SaktanuthPeak/durian-bot/docs/doc.pdf

โครงร่าร่ | งรายงาน Durian Bot (Mini Project 240-319)
ไฟล์นี้เป็น โครงร่าร่ | ง + เนื้อหาคร่าร่ | วๆ สำ หรับรั | นำ ไปเรียรี | บเรียรี | งลงรายงาน Word อิงโครงสร้าร้ | งจากตัวอย่าย่ | ง Report_SmartHome-
1.pdf และ MiniProject-SmartCargo-2.pdf
ข้อข้ | ความใน [วงเล็บเหลี่ยม] = ต้องเติมเอง (ชื่อชื่ | , รูปถ่าย, ผลทดลอง, ราคา)
แผนภาพเขียขี | นด้วย Mermaid — เปิดใน VS Code/GitHub เพื่อพื่ | ดู หรือรื | วางที่ https://mermaid.live แล้ว export เป็น PNG

## ไปแปะใน Word

Code ที่แปะเป็น ส่วส่ | นสำ คัญที่ตัดมา พร้อร้ | มชื่อชื่ | ไฟล์และบรรทัดอ้างอิง ไม่ใม่ | ช่ทั้ช่ | ทั้งทั้ | ไฟล์
ภาคผนวก Z ท้ายไฟล์เป็นบันบั | ทึกสำ หรับรั | ทีม (สิ่งสิ่ | ที่ยังยั | ขาดตามเนื้อหาวิชวิ | า + จุดที่ควรแก้) — ลบออกก่อนส่งส่
หน้าน้ | ปก

### รายงาน

Mini project วิชวิ | า 240-319 Embedded System Developer Module
หุ่นหุ่ | ยนต์ฉีดพ่นพ่ | ยาในสวนทุเทุ | รียรี | น (Durian Bot)
จัดจั | ทำ โดย
[ชื่อชื่ | -สกุลกุ | ] รหัสหั | นักนั | ศึกษา [xxxxxxxxxx] Section [xx]
[ชื่อชื่ | -สกุลกุ | ] รหัสหั | นักนั | ศึกษา [xxxxxxxxxx] Section [xx]
[ชื่อชื่ | -สกุลกุ | ] รหัสหั | นักนั | ศึกษา [xxxxxxxxxx] Section [xx]

### เสนอ รศ.ดร. ปัญญยศ ไชยกาฬ

ผศ.ดร. วชรินริ | ทร์ แก้วอภิชัยชั
รศ.ดร. ทวีศัวี | ศักดิ์ เรือรื | งพีรพี | ะกุลกุ
รายงานฉบับบั | นี้เนี้ป็นป็ | ส่วส่ | นหนึ่งนึ่ | ของรายวิชวิ | า 240-319 ชุดวิชวิ | านักพัฒพั | นาระบบฝังตัว
(Embedded System Developer Module)
คณะวิศวิ | วกรรมศาสตร์ สาขาวิศวิ | วกรรมคอมพิวพิ | เตอร์
มหาวิทวิ | ยาลัยสงขลานครินริ | ทร์ วิทวิ | ยาเขตหาดใหญ่
ภาคเรียรี | นที่ | [x] ปีกปี | ารศึกษา [25xx]

คำ นำ

รายงานฉบับบั | นี้เป็นส่วส่ | นหนึ่งของรายวิชวิ | า 240-319 ชุดวิชวิ | านักพัฒพั | นาระบบฝังตัว (Embedded System Developer Module) จัดจั | ทำ ขึ้นขึ้ | เพื่อพื่
ศึกษา ออกแบบ และพัฒพั | นาหุ่นหุ่ | ยนต์ต้นแบบ "Durian Bot" สำ หรับรั | ช่วช่ | ยฉีดพ่นพ่ | สารในสวนทุเทุ | รียรี | น โดยประยุกต์ใช้คช้ | วามรู้ใรู้ | นรายวิชา วิ | ได้แก่
GPIO, PWM, ADC, Interrupt, Watchdog Timer, Sleep Mode, UART/USART, SPI, I2C, CAN Bus, RTOS, EEPROM และการ
ประมวลผลภาพด้วย OpenCV ร่วร่ | มกับ Raspberry Pi และเว็บว็ | แอปพลิเคชันชั | เพื่อพื่ | ให้ผู้ห้ | คผู้ วบคุมคุ | สั่งสั่ | งานและติดตามสถานะหุ่นหุ่ | ยนต์ได้จากระยะ

## ไกล

คณะผู้จัผู้ ดจั | ทำ หวังวั | ว่าว่ | รายงานฉบับบั | นี้จะเป็นประโยชน์แก่ผู้อ่ผู้ อ่าน หากมีข้มี | อข้ | ผิดผิ | พลาดประการใด คณะผู้จัผู้ ดจั | ทำ ขออภัยมา ณ ที่นี้
คณะผู้จัผู้ ดจั | ทำ | [วันวั | ที่]

สารบัญบั | / สารบัญบั | ภาพ / สารบัญบั | ตาราง
สร้าร้ | งอัตโนมัติมั ติใน Word (References → Table of Contents / Insert Table of Figures) หลังจัดจั | หัวหั | ข้อข้ | ด้วย Heading Style

บทที่ 1 บทนำ

# 1.1 ที่มาและความสำ คัญ

ทุเทุ | รียรี | นเป็นพืชพื | เศรษฐกิจสำ คัญของภาคใต้ การดูแดู | ลสวนต้องฉีดพ่นพ่ | สารป้อป้ | งกันโรคและแมลง (เช่นช่ | โรครากเน่าโคนเน่า, หนอนเจาะผล) อย่าย่ | ง
สม่ำ เสมอ ในทางปฏิบัติบั ติเกษตรกรต้องแบกถังหรือรื | ลากสายพ่นพ่ | เดินไปตามแถวต้นเอง ซึ่งซึ่
เสี่ยสี่ | งสัมสั | ผัสผั | สารเคมีโมี | ดยตรงทั้งทั้ | ทางผิวผิ | หนังและการหายใจ
ใช้แช้ | รงงานและเวลามาก โดยเฉพาะสวนขนาดใหญ่ที่แรงงานขาดแคลน
ปริมริ | าณการพ่นพ่ | ไม่สม่ | ม่ำ เสมอขึ้นขึ้ | กับผู้พ่ผู้ นพ่ | แต่ละคน
คณะผู้จัผู้ ดจั | ทำ จึงจึ | พัฒพั | นา Durian Bot หุ่นหุ่ | ยนต์ขับขั | เคลื่อน 4 ล้อที่ติดตั้งตั้ | ปั๊มและหัวหั | ฉีดปรับรั | มุมได้ ผู้คผู้ วบคุมคุ | บังบั | คับจาก ระยะไกลได้ 2 ช่อช่ | งทาง คือ
จอย PS2 ผ่าผ่ | น CAN Bus และหน้าเว็บว็ | ผ่าผ่ | น Wi-Fi ของ Raspberry Pi บนตัวหุ่นหุ่ | พร้อร้ | ม ภาพจากกล้องและสถานะของหุ่นหุ่ | แบบเวลาจริงริ | ช่วช่ | ย
ให้ผู้ห้ | คผู้ วบคุมคุ | อยู่ห่ยู่ | าห่ | งจากละอองสารเคมี
1.2 วัตวั | ถุปถุ | ระสงค์
1. เพื่อพื่ | ออกแบบและพัฒพั | นาหุ่นหุ่ | ยนต์ต้นแบบสำ หรับรั | ฉีดพ่นพ่ | สารในสวนทุเทุ | รียรี | นที่ควบคุมคุ | จากระยะไกลได้
2. เพื่อพื่ | ประยุกต์ใช้กช้ | ารสื่อสื่ | สารระหว่าว่ | งไมโครคอนโทรลเลอร์หร์ | ลายบอร์ดร์ | ผ่าผ่ | น CAN Bus, SPI, I2C และ UART
3. เพื่อพื่ | ออกแบบระบบความปลอดภัย (fail-safe) เช่นช่ | Watchdog Timer และการหยุดอัตโนมัติมั ติเมื่อมื่ | สัญสั | ญาณขาด
4. เพื่อพื่ | พัฒพั | นาเว็บว็ | แดชบอร์ดร์ | บน Raspberry Pi สำ หรับรั | สั่งสั่ | งาน แสดงภาพจากกล้อง (OpenCV) และสถานะหุ่นหุ่ | ยนต์

# 1.3 ขอบเขตของโครงงาน

เป็นการจำ ลองตัวต้นแบบขนาดเล็ก โดยใช้คช้ | วามรู้ใรู้ | นรายวิชวิ | า Embedded System Developer Module
ใช้น้ำช้ | น้ำ | แทนสารเคมีจมี | ริงริ | ในการทดสอบ
ควบคุมคุ | แบบ manual (ผู้คผู้ วบคุมคุ | บังบั | คับ) ยังยั | ไม่มีม่ | กมี | ารนำ ทางอัตโนมัติมั ติ
ระยะการควบคุมคุ | ผ่าผ่ | นเว็บว็ | จำ กัดตามระยะ Wi-Fi Access Point ของ Raspberry Pi

บทที่ 2 เอกสารและทฤษฎีที่เกี่ยวข้อข้ | ง
แนวเดียวกับตัวอย่าย่ | ง SmartHome บทที่ 2: อธิบธิ | ายอุปกรณ์แต่ละตัว + รูปประกอบ (ภาพ pinout) แล้วเพิ่มพิ่ | ส่วส่ | น 2.2 ทฤษฎีตาม
เนื้อหาวิชวิ | า ที่ผูกผู | กับโค้ดจริงริ | ในโปรเจกต์ (อาจารย์น่ย์ | น่าจะดูส่ดู | วส่ | นนี้เป็นหลัก)
ที่ | กี่

เกี่ยวข้อข้ | ง
หัวข้อข้ ย่อย่ ย | เนื้อนื้ หาคร่าร่ วๆ | ใช้ใช้ นโปรเจกต์

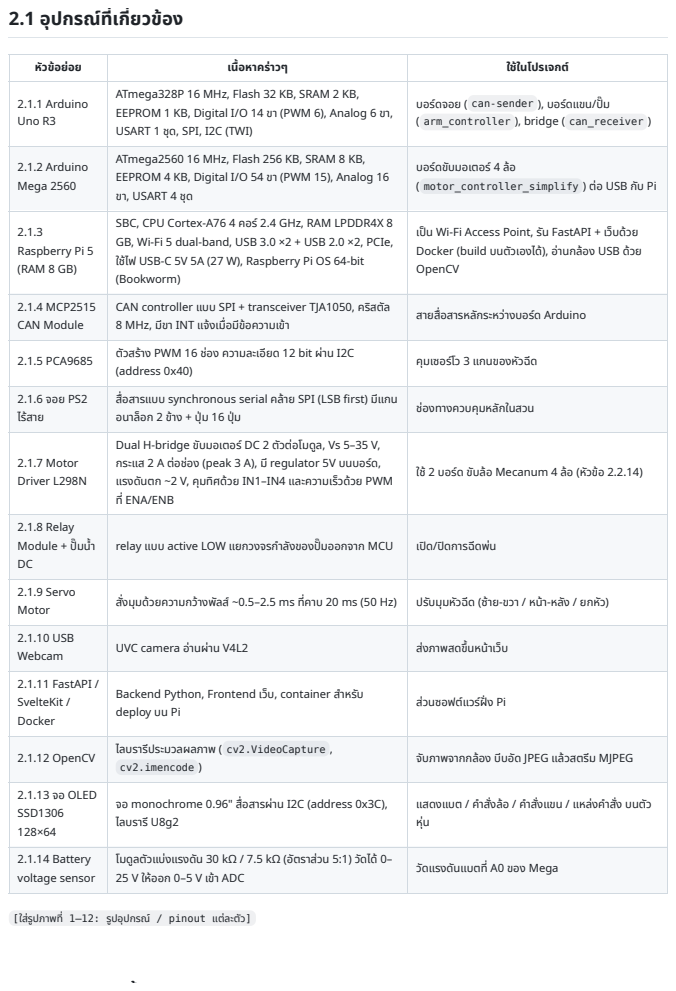
[picture p8: page 5]
2.1 อุปกรณ์ที่ณ์ ที่; ภาพที่; อุปกรณ์ / pinout ณ์; แต่ละตัว]

2.1.1 Arduino Uno R3 | ATmega328P 16 MHz, Flash 32 KB, SRAM 2 KB, EEPROM 1 KB, Digital I/O 14 ขา (PWM 6), Analog 6 ขา, USART 1 ชุด, SPI, I2C (TWI) | บอร์ดร์ จอย ( can-sender ), บอร์ดร์ แขน/ปั๊ม ( arm_controller ), bridge ( can_receiver )

2.1.2 Arduino Mega 2560 | ATmega2560 16 MHz, Flash 256 KB, SRAM 8 KB, EEPROM 4 KB, Digital I/O 54 ขา (PWM 15), Analog 16 ขา, USART 4 ชุด | บอร์ดร์ ขับขั มอเตอร์ 4 ล้อ ( motor_controller_simplify ) ต่อ USB กับ Pi

2.1.3 Raspberry Pi 5 (RAM 8 GB) | SBC, CPU Cortex-A76 4 คอร์ 2.4 GHz, RAM LPDDR4X 8 GB, Wi-Fi 5 dual-band, USB 3.0 ×2 + USB 2.0 ×2, PCIe, ใช้ไช้ ฟ USB-C 5V 5A (27 W), Raspberry Pi OS 64-bit (Bookworm) | เป็นป็ Wi-Fi Access Point, รันรั FastAPI + เว็บว็ ด้วย Docker (build บนตัวเองได้)ด้ , อ่านกล้อง USB ด้วด้ ย OpenCV

2.1.4 MCP2515 CAN Module | CAN controller แบบ SPI + transceiver TJA1050, คริสริ ตัล 8 MHz, มีขมี า INT แจ้งจ้ เมื่อมื่ มีข้มี อข้ ความเข้าข้ | สายสื่อสื่ สารหลักระหว่าว่ งบอร์ดร์ Arduino

2.1.5 PCA9685 | ตัวสร้าร้ ง PWM 16 ช่อช่ ง ความละเอียด 12 bit ผ่าผ่ น I2C (address 0x40) | คุมคุ เซอร์โร์ ว 3 แกนของหัวหั ฉีด

2.1.6 จอย PS2 ไร้สร้ าย | สื่อสื่ สารแบบ synchronous serial คล้าย SPI (LSB first) มีแมี กน อนาล็อก 2 ข้าข้ ง + ปุ่มปุ่ 16 ปุ่มปุ่ | ช่อช่ งทางควบคุมคุ หลักในสวน

2.1.7 Motor Driver L298N | Dual H-bridge ขับขั มอเตอร์ DC 2 ตัวต่อโมดูลดู , Vs 5–35 V, กระแส 2 A ต่อช่อช่ ง (peak 3 A), มี regulator 5V บนบอร์ดร์ , แรงดันดั ตก ~2 V, คุมคุ ทิศด้วด้ ย IN1–IN4 และความเร็วร็ ด้วด้ ย PWM ที่ ENA/ENB | ใช้ 2 บอร์ดร์ ขับขั ล้อ Mecanum 4 ล้อ (หัวหั ข้อข้ 2.2.14)

2.1.8 Relay Module + ปั๊มน้ำ DC | relay แบบ active LOW แยกวงจรกำ ลังของปั๊มออกจาก MCU | เปิดปิ /ปิดปิ การฉีดพ่นพ่

2.1.9 Servo Motor | สั่งสั่ มุมด้วด้ ยความกว้าว้ งพัลพั ส์ ~0.5–2.5 ms ที่คาบ 20 ms (50 Hz) | ปรับรั มุมหัวหั ฉีด (ซ้าซ้ ย-ขวา / หน้าน้ -หลัง / ยกหัวหั )

2.1.10 USB Webcam | UVC camera อ่านผ่าผ่ น V4L2 | ส่งส่ ภาพสดขึ้นขึ้ หน้าน้ เว็บว็

2.1.11 FastAPI / SvelteKit / Docker | Backend Python, Frontend เว็บว็ , container สำ หรับรั deploy บน Pi | ส่วส่ นซอฟต์แวร์ฝั่ร์ ฝั่ ง Pi

2.1.12 OpenCV | ไลบรารีปรี ระมวลผลภาพ ( cv2.VideoCapture , cv2.imencode ) | จับจั ภาพจากกล้อง บีบบี อัด JPEG แล้วสตรีมรี MJPEG

2.1.13 จอ OLED SSD1306 128×64 | จอ monochrome 0.96" สื่อสื่ สารผ่าผ่ น I2C (address 0x3C), ไลบรารี U8g2 | แสดงแบต / คำ สั่งสั่ ล้อ / คำ สั่งสั่ แขน / แหล่งคำ สั่งสั่ บนตัว หุ่นหุ่

2.1.14 Battery voltage sensor | โมดูลดู ตัวแบ่งบ่ แรงดันดั 30 kΩ / 7.5 kΩ (อัตราส่วส่ น 5:1) วัดวั ได้ 0– 25 V ให้อห้ อก 0–5 V เข้าข้ ADC | วัดวั แรงดันดั แบตที่ A0 ของ Mega

2.2 ทฤษฎีตามเนื้อนื้ | หาวิชวิ | าและการนำ ไปใช้ใช้ | นโปรเจกต์
แต่ละหัวหั | ข้อข้ | เขียขี | น 3 ส่วส่ | น: หลักการ → register/ค่าที่เกี่ยวข้อข้ | ง → ใช้ที่ช้ ที่ไหนในโปรเจกต์ สถานะ ✅ = มีใมี | นโค้ดแล้ว, ⚠️ = มีบมี | างส่วส่ | น/
อยู่ใยู่ | นไฟล์รุ่นรุ่ | เก่า, ❌ = ยังยั | ไม่มีม่ มี | (ดูภดู | าคผนวก Z)

# 2.2.1 GPIO และ Digital Output ✅

ขา I/O ของ AVR ควบคุมคุ | ด้วย 3 register: DDRx (ทิศทาง), PORTx (เขียขี | นค่า / เปิด pull-up), PINx (อ่านค่า)
ใช้ใช้ | น: สั่งสั่ | ทิศมอเตอร์ IN1/IN2 , ขา relay ปั๊ม (D4, active LOW), ขา chip select ของ MCP2515
ตัวอย่าย่ | งระดับ register ใน arm_controller.ino : DDRD &= ~(1 << PD2); PORTD |= (1 << PD2); = ตั้งตั้ | D2 เป็น input +

## pull-up

# 2.2.2 PWM (Pulse Width Modulation) ✅

## PWM สร้าร้ งจาก Timer/Counter ของ MCU โดยเทียบค่า counter กับ OCRnx → ได้ duty cycle

Hardware PWM บน Mega ( analogWrite ) — ขา 5 = Timer3 (OC3A), ขา 6/7/8 = Timer4 (OC4A/B/C) ความถี่ default
~490 Hz, ค่า 0–255 → ใช้คุช้ | มคุ | ความเร็วร็ | ล้อ ( MOTOR_PWM = 150 ≈ 59% duty)
External PWM ผ่าน PCA9685 — oscillator 25 MHz, 12 bit (0–4095) ตั้งตั้ | prescale ให้ไห้ | ด้ 50 Hz สำ หรับรั | เซอร์โร์ | ว
prescale = round(25,000,000 / (4096 × f)) − 1 | (โค้ดคูณคู | f × 0.9 ชดเชย oscillator คลาดเคลื่อน)
1 tick ที่ | 50 Hz = 20 ms / 4096 ≈ 4.88 µs
ค่า 150 ≈ 0.73 ms, 305 ≈ 1.49 ms (กึ่งกลาง), 450 ≈ 2.20 ms → constrain(150..450) กันเซอร์โร์ | วชนสุดสุ

# 2.2.3 ADC (Analog to Digital Converter) ✅

ADC ของ AVR เป็นแบบ successive approximation 10 bit (0–1023), เลือกช่อช่ | งด้วย ADMUX , เริ่มริ่ | แปลงด้วย ADSC ใน
ADCSRA และรอจน ADSC กลับเป็น 0, clock ของ ADC ต้องอยู่ใยู่ | นช่วช่ | ง 50–200 kHz → 16 MHz / 128 = 125 kHz (1 ครั้งรั้ | ≈ 13

## clock ≈ 104 µs)

V = ADC × Vref / 1023 — วัดวั | แบตผ่าผ่ | นตัวแบ่งบ่ | แรงดัน Vbat = V × (R1+R2)/R2
ในโปรเจกต์: Mega ( motor_controller_simplify ) อ่านโมดูลดู | วัดวั | แรงดันแบต 0–25 V (30 kΩ / 7.5 kΩ) ที่ A0 เขียขี | นระดับ
register แทน analogRead() แล้วเฉลี่ย 8 ค่า (moving average) ลด noise จากมอเตอร์ ส่งส่ | ขึ้นขึ้ | เว็บว็ | ใน telemetry MS1

# 2.2.4 Interrupt ✅

Interrupt ทำ ให้ CPU หยุดงานปัจจุบันบั | ไปทำ | ISR ทันทีเมื่อมื่ | เกิดเหตุกา ตุ | รณ์ แทนการวนเช็กช็ | (polling)
External interrupt INT0 (ขา D2 ของ Uno): ตั้งตั้ | ชนิด edge ใน EICRA ( ISC01:ISC00 ), เปิดใน EIMSK , flag อยู่ใยู่ | น EIFR
ในโปรเจกต์ ( arm_controller.ino ): ขา INT ของ MCP2515 ดึงลง LOW เมื่อมื่ | มีข้มี | อข้ | ความ CAN → trigger ขอบขาลง → ISR ตั้งตั้
แค่ flag volatile bool isDataReady แล้วให้ loop() ไปอ่าน (หลัก "ISR ต้องสั้นสั้ | ")
บอร์ดร์ | Mega รุ่นรุ่ | เต็มใช้ attachInterrupt(..., RISING) นับพัลพั | ส์ encoder ล้อ ( motor_controller_mega/encoder.cpp )

# 2.2.5 Watchdog Timer (WDT) ✅

WDT เป็น timer อิสระ (oscillator 128 kHz ภายใน) ถ้าโปรแกรมไม่ wdt_reset() ภายในเวลาที่กำ หนด MCU จะ reset ตัวเอง →
กันโปรแกรมค้าง (เช่นช่ | ติดใน while รอ I2C/SPI)
ตั้งตั้ | ค่าผ่าผ่ | น WDTCSR : ต้องเขียขี | น WDCE|WDE ก่อนภายใน 4 clock cycle (timed sequence) แล้วจึงจึ | ตั้งตั้ | prescaler WDP3..0
WDT มี 3 โหมด: Interrupt ( WDIE ), System Reset ( WDE ), และ Interrupt + System Reset ( WDIE|WDE ) ที่ครบเวลาครั้งรั้
แรกจะเข้าข้ | ISR WDT_vect ก่อน (hardware ล้าง WDIE เอง) ถ้ายังยั | ไม่ wdt_reset() อีกรอบจึงจึ | reset
ในโปรเจกต์ ( arm_controller.ino ): ตั้งตั้ | timeout 500 ms ( WDP2|WDP0 ) แบบ Interrupt + System Reset
ครบเวลาครั้งรั้ | แรก → ISR ปิดปั๊มทันทีและบันบั | ทึกจำ นวนครั้งรั้ | ที่ค้างลง EEPROM → อีก 500 ms ถ้ายังยั | ค้างจึงจึ | reset
ปิด WDT และเคลียร์ WDRF ใน MCUSR ตอนบูตก่อน (กัน reset loop), wdt_reset() ทุกทุ | รอบ loop()
หลัง reset เซอร์โร์ | วจะถูกถู | สั่งสั่ | กลับตำ แหน่งปลอดภัยทันทีใน setup()
Mega ( motor_controller_simplify ) ใช้ WDT ไม่ไม่ | ด้ เพราะ FreeRTOS ใช้ WDT เป็นตัวสร้าร้ | ง tick

# 2.2.6 Sleep Mode / Power Management ✅

AVR มี sleep 6 ระดับ (Idle, ADC Noise Reduction, Power-down, Power-save, Standby, Extended Standby) เลือกผ่าผ่ | น
SMCR ( SM2..0 ) แล้วสั่งสั่ | sleep_cpu() ปลุกลุ | ด้วย interrupt
Power-down ประหยัดยั | ที่สุดสุ | : หยุด oscillator หลักและ I/O clock ทั้งทั้ | หมด (Timer0 หยุด → millis() หยุดนับระหว่าว่ | งหลับ)
ปลุกลุ | ได้เฉพาะ external interrupt แบบ low level, pin change, TWI address match หรือรื | WDT — INT0 แบบขอบ (edge)
ต้องใช้ I/O clock จึงจึ | ปลุกลุ | จาก Power-down ไม่ไม่ | ด้
ในโปรเจกต์ ( arm_controller.ino ): ไม่มีม่ | คำมี | คำ | สั่งสั่ | ขยับยั | เกิน 30 วินวิ | าที → ปิดปั๊ม หยุดแขน แล้ว เข้าข้ | Power-down จริงริ

ก่อนหลับ: Serial.flush() , wdt_disable() , ปิด ADC, ปิด BOD ( sleep_bod_disable() ), เปลี่ยน INT0 เป็น low

## level

MCP2515 ดึงขา INT ลงเมื่อมื่ | มีข้มี | อข้ | ความ CAN → ตื่น → ISR ปิด INT0 ชั่วชั่ | คราว (low level จะเข้าข้ | ISR ซ้ำ ไม่หม่ | ยุด) → กลับเป็น

## ขอบขาลง + เปิด WDT

ถ้าข้อข้ | ความเป็นแค่ STOP heartbeat ของจอย (ทุกทุ | 50 ms) จะอ่านทิ้งแล้วหลับต่อ ตื่นจริงริ | เมื่อมื่ | มีคำมี | คำ | สั่งสั่ | ขยับยั
can_receiver.ino ยังยั | เป็น software sleep (ตัดปั๊มอย่าย่ | งเดียว)

# 2.2.7 UART / USART ✅

USART = asynchronous serial: start bit + 8 data + (parity) + stop bit, ไม่มีม่ | สมี | าย clock ทั้งทั้ | สองฝั่งต้องตั้งตั้ | baud ตรงกัน
Baud rate จาก UBRRn = F_CPU / (16 × baud) − 1 (หรือรื | /8 เมื่อมื่ | เปิด U2X) — ที่ 115200 บน 16 MHz ใช้โช้ | หมด U2X, UBRR

## = 16 (error ~2.1%)

ในโปรเจกต์: USB ของ Arduino คือชิปชิ | ATmega16U2 แปลง USB ↔ USART0 ของ MCU → Pi เห็นห็ | เป็น /dev/ttyACM0 ใช้
115200 8N1 ส่งส่ | ข้อข้ | ความเป็นบรรทัด ASCII จบด้วย \n พร้อร้ | ม XOR checksum (ออกแบบ protocol ในบทที่ 3.4)

# 2.2.8 SPI ✅

## Synchronous serial แบบ master/slave 4 สาย: SCK , MOSI , MISO , SS/CS (full-duplex)

## ในโปรเจกต์:

Arduino ↔ MCP2515 ผ่าผ่ | น hardware SPI (Uno: D10–D13, Mega: D50–D53) — ต้องตั้งตั้ | ขา SS ของ MCU เป็น
OUTPUT ไม่งั้ม่ | งั้นงั้ | SPI จะหลุดลุ | ไปเป็น slave mode
Arduino ↔ จอย PS2 เป็น software SPI (bit-bang) บน A0–A3 ส่งส่ | แบบ LSB first, คำ สั่งสั่ | 0x01 0x42

( PS2_Controller.cpp )

# 2.2.9 I2C (TWI) ✅

2 สาย SDA / SCL (open-drain + pull-up), หลายอุปกรณ์บนบัสบั | เดียวกันแยกด้วย address 7 bit
ลำ ดับการเขียขี | น register: START → address+W → register → data… → STOP
ในโปรเจกต์: Uno (A4/A5) ↔ PCA9685 (0x40) — เขียขี | น driver เองระดับ register ( PCA9685_Control.cpp ) ไม่ใม่ | ช้ไช้ | ลบรารี
Adafruit: MODE1 (0x00) , PRESCALE (0xFE) , LED0_ON_L (0x06) + 4×channel และใช้ Auto-Increment เขียขี | น 4 byte
ต่อเนื่องในครั้งรั้ | เดียว
ในโปรเจกต์: Mega (D20 SDA / D21 SCL) ↔ จอ OLED SSD1306 (0x3C) ผ่าผ่ | น hardware I2C (TWI) ที่ 400 kHz (fast

## mode) ด้วยไลบรารี U8g2

Hardware vs Software I2C: โค้ดตัวอย่าย่ | งเดิม ( receiver-canbus.ino ) ใช้ software I2C (bit-bang) บน D6/D7 ของ
Uno แต่บน Mega ขา D6/D7 เป็น PWM ของ L298N จึงจึ | ย้าย้ | ยมาใช้ TWI ของชิปชิ | จริงริ | — ฮาร์ดร์ | แวร์สร์ | ร้าร้ | ง
clock/START/STOP/ACK ให้ CPU ว่าว่ | งกว่าว่ | และเร็วร็ | กว่าว่
Page buffer: จอ 128×64 = 1024 byte ถ้าเก็บทั้งทั้ | จอใน RAM จะกิน 1/8 ของ SRAM Mega จึงจึ | ใช้โช้ | หมด _1_ ของ U8g2

## วาดทีละ page (128×8 px = 128 byte) วน 8 รอบ ( firstPage() / nextPage() )

เวลาส่งส่ 1 เฟรม: 1024 byte × 9 bit (8 data + ACK) ≈ 9,216 bit → ที่ 400 kHz ≈ 23 ms (ที่ 100 kHz ≈ 92 ms)

# 2.2.10 CAN Bus ✅

บัสบั | differential 2 สาย (CAN_H/CAN_L) ทนสัญสั | ญาณรบกวนสูงสู | , multi-master, arbitration ด้วย ID (ID ต่ำ | = priority สูงสู | ), มี
CRC/ACK ในตัว ต้องมีตัมี | ตัวต้านทาน terminate 120 Ω ที่ปลายสายทั้งทั้ | 2 ด้าน
ในโปรเจกต์: 500 kbps, Standard ID 11 bit, payload 1 byte = รหัสหั | คำ สั่งสั่ | , ส่งส่ | ซ้ำ ทุกทุ | 50 ms เป็น heartbeat (ถ้าไม่ไม่ | ด้รับรั | เกิน
timeout ถือว่าว่ | สัญสั | ญาณขาด → หยุด)

# 2.2.11 RTOS ✅

RTOS แบ่งบ่ | งานเป็น task มี priority, scheduler แบบ preemptive สลับ task ตาม tick, และมีกมี | ลไกสื่อสื่ | สารระหว่าว่ | ง task
Queue — ส่งส่ | ข้อข้ | มูลระหว่าว่ | ง task แบบ FIFO (copy by value) task ที่รอจะ block ไม่กิม่ กิน CPU
Binary semaphore — ใช้ส่ช้ | งส่ | สัญสั | ญาณ เช่นช่ | ISR ปลุกลุ | task ( xSemaphoreGiveFromISR )
Mutex — ล็อกทรัพรั | ยากรที่ใช้ร่ช้ | วร่ | มกัน (SPI, Serial) มี priority inheritance กัน priority inversion
Task notification — ปลุกลุ | task เฉพาะตัวแบบเบาที่สุดสุ
FreeRTOS บน AVR (ไลบรารี Arduino_FreeRTOS) ใช้ Watchdog Timer เป็นป็ | ตัวสร้าร้ | ง tick (~15 ms) และ loop() กลายเป็น

## idle task

ในโปรเจกต์: Mega ( motor_controller_simplify ) แบ่งบ่ | เป็น 5 task — CAN_RX , CONTROL , SERIAL_RX , TELEMETRY ,
DISPLAY ใช้คช้ | รบทั้งทั้ | queue, semaphore จาก ISR, mutex 3 ตัว และ task notification (รายละเอียดหัวหั | ข้อข้ | 4.4)

# 2.2.12 EEPROM ✅

หน่วยความจำ | non-volatile ภายใน MCU (Uno 1 KB, Mega 4 KB) เขียขี | นได้ ~100,000 ครั้งรั้ | /ช่อช่ | ง ใช้เช้ | วลาเขียขี | น ~3.3 ms ต่อ byte
จึงจึ | ควรใช้ EEPROM.update() / EEPROM.put() (เขียขี | นเฉพาะ byte ที่ค่าเปลี่ยน) และเก็บ magic/version ไว้ตว้ | รวจความถูกถู | ต้อง
ของข้อข้ | มูล (EEPROM ที่ยังยั | ไม่เม่ | คยเขียขี | นอ่านได้ 0xFF ทุกทุ | byte)
ในโปรเจกต์ ( arm_controller.ino ): เก็บ struct ArmStats = magic 0xA7A7 , version, จำ นวนการบูต, จำ นวนครั้งรั้ | ที่
Watchdog ทำ งาน (เขียขี | นจากใน ISR) และ เวลาเปิดปั๊มสะสม (ใช้ปช้ | ระเมินมิ | ปริมริ | าณสาร) — บันบั | ทึกเฉพาะตอนมีเมี | หตุกตุ | ารณ์ (บูต / ปิดปั๊ม /
WDT) ไม่ใม่ | ช่ทุช่ | กทุ | รอบ loop
ไม่เม่ | ก็บตำ แหน่งเซอร์โร์ | ว เพราะตอนบูต (รวมถึงหลัง WDT reset) ต้องดึงแขนกลับจุดปลอดภัยเสมอ
อีกตัวอย่าย่ | ง: firmware/motor_controller_rtos_pid/pid_config.cpp เก็บค่า PID + magic 0x5049 + version

# 2.2.13 OpenCV และการประมวลผลภาพ ✅

cv2.VideoCapture เปิดกล้องผ่าผ่ | น V4L2, ตั้งตั้ | FOURCC เป็น MJPG ให้กห้ | ล้องบีบบี | อัดเองลดภาระ USB/CPU

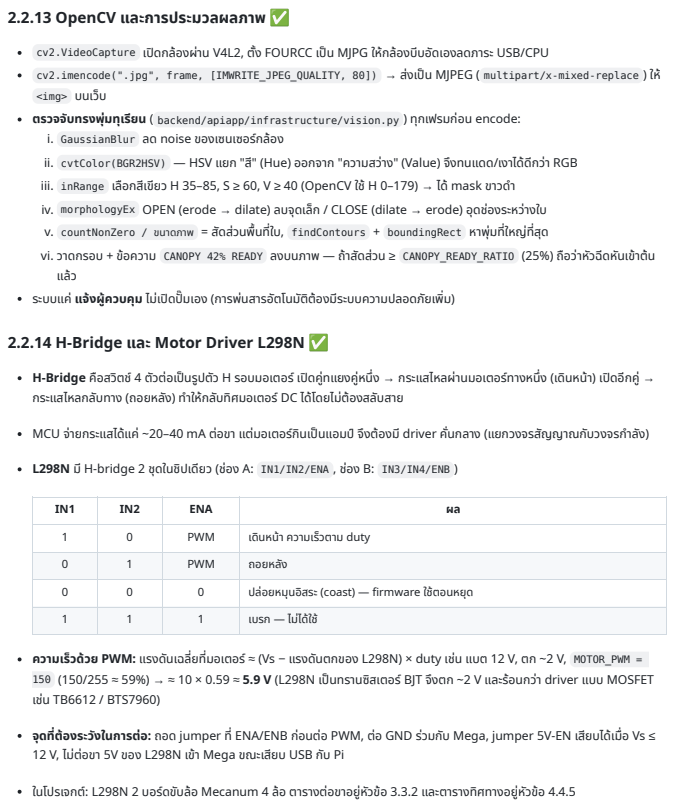
[picture p9: page 9]
cv2.imencode(".jpg", frame, [IMWRITE_JPEG_QUALITY, 80]) → ส่งส่; เป็น MJPEG ( multipart/x-mixed-replace ) ให้; ตรวจจับจั; ทรงพุ่มพุ่; น ( backend/apiapp/infrastructure/vision.py ) ทุกทุ; เฟรมก่อน encode:; i. GaussianBlur ลด noise ของเซนเซอร์กร์; ii. cvtColor(BGR2HSV) — HSV แยก "สี"สี; (Hue) ออกจาก "ความสว่าว่; ง" (Value) จึงจึ; ทนแดด/เงาได้ดีกว่าว่; RGB; iii. inRange เลือกสีเสี; ว H 35–85, S ≥ 60, V ≥ 40 (OpenCV ใช้ H 0–179) → ได้ mask ขาวดำ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

<img> บนเว็บว็

2.2.14 H-Bridge และ Motor Driver L298N ✅

IN1 | IN2 | ENA | ผล
1 | 0 | PWM | เดินดิ หน้าน้ ความเร็วร็ ตาม duty
0 | 1 | PWM | ถอยหลัง
0 | 0 | 0 | ปล่อยหมุนอิสระ (coast) — firmware ใช้ตช้ อนหยุด
1 | 1 | 1 | เบรก — ไม่ไม่ ด้ใด้ ช้

# บทที่ 3 ระบบการทำ งานและการเชื่อชื่ มต่อ

# 3.1 การทำ งานโดยภาพรวม (System Architecture)

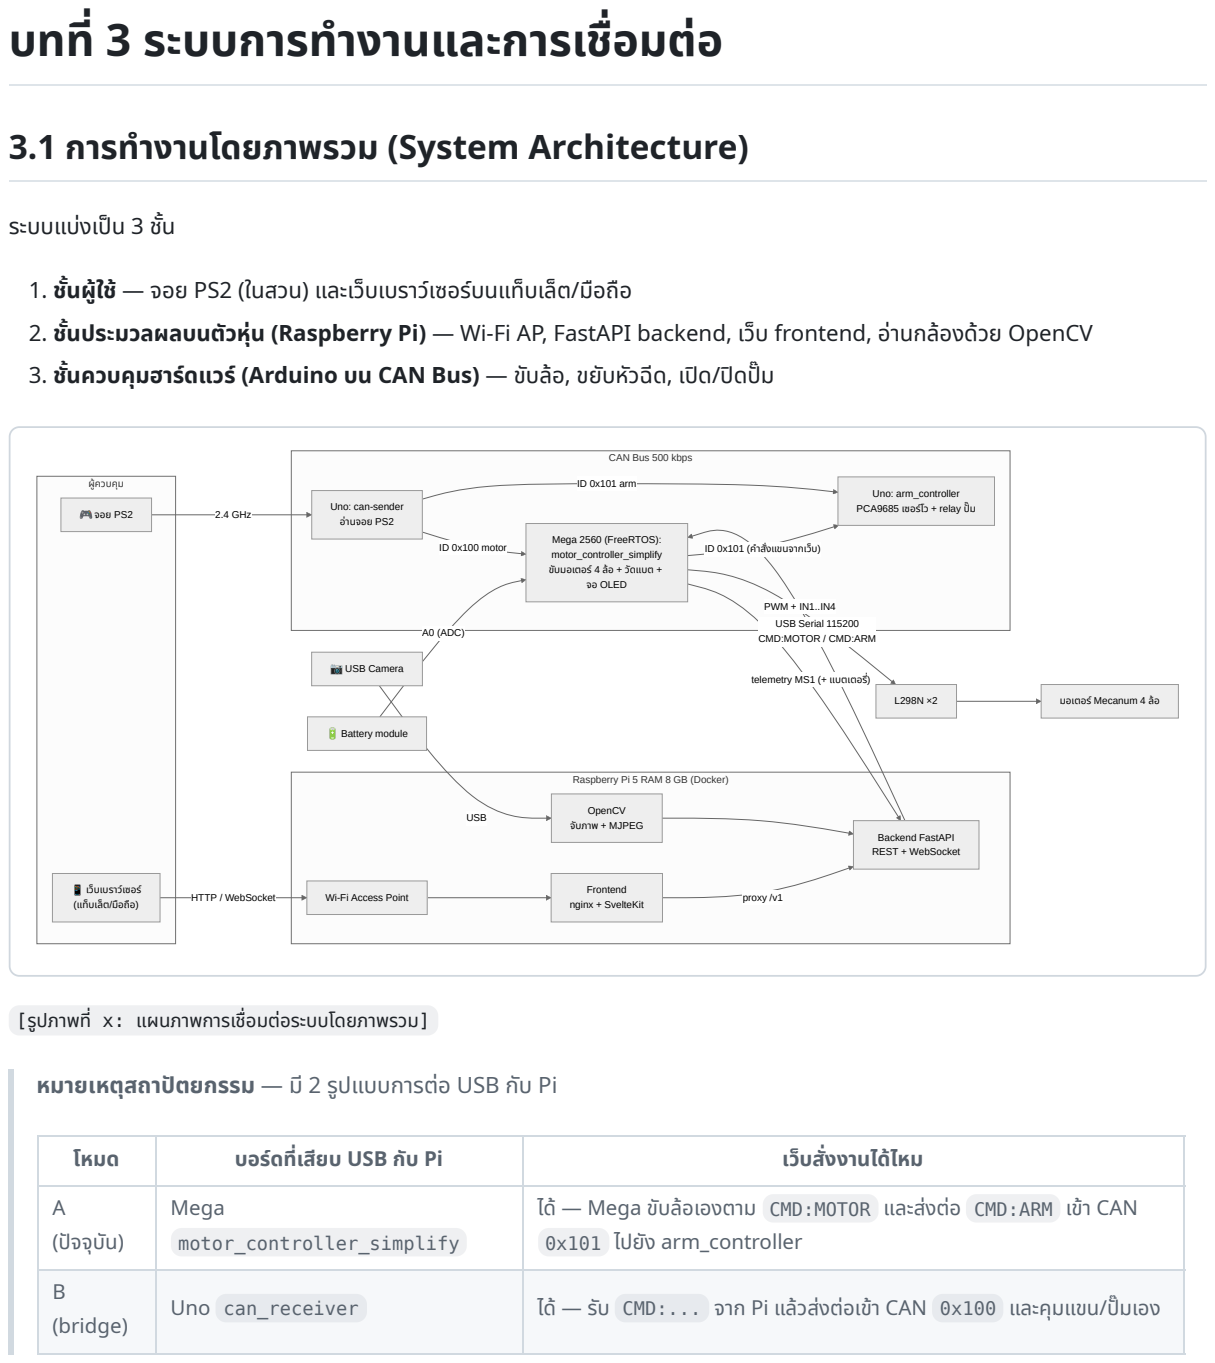
[picture p10: page 10]
ระบบแบ่งบ่; ผู้ใช้ — จอย PS2 (ในสวน) และเว็บว็; เบราว์เว์; ซอร์บร์; นแท็บเล็ต/มือมื; ประมวลผลบนตัวหุ่นหุ่; (Raspberry Pi) — Wi-Fi AP, FastAPI backend, เว็บว็; frontend, อ่านกล้องด้วย OpenCV; ควบคุมคุ; ฮาร์ดร์; แวร์ (Arduino บน CAN Bus) — ขับขั; 2.4 GHz; HTTP / WebSocket; proxy /v1; USB; ID 0x100 motor; ID 0x101 arm; telemetry MS1 (+ แบตเตอรี่)รี่; A0 (ADC); แขนจากเว็บว็; 🎮 จอย PS2; ซอร์; (แท็บเล็ต/มือมื; Wi-Fi Access Point; Frontend; nginx + SvelteKit; OpenCV; ภาพ + MJPEG; 📷 USB Camera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

CAN Bus 500 kbps

ผู้คผู้ วบคุมคุ

PWM + IN1..IN4
USB Serial 115200 CMD:MOTOR / CMD:ARM

Raspberry Pi 5 RAM 8 GB (Docker)

Backend FastAPI REST + WebSocket

โหมด | บอร์ดร์ ที่เสียสี บ USB กับ Pi | เว็บว็ สั่งสั่ งานได้ไหม
A (ปัจจุบันบั ) | Mega motor_controller_simplify | ได้ — Mega ขับขั ล้อเองตาม CMD:MOTOR และส่งส่ ต่อ CMD:ARM เข้าข้ CAN 0x101 ไปยังยั arm_controller

B (bridge) | Uno can_receiver | ได้ — รับรั CMD:... จาก Pi แล้วส่งส่ ต่อเข้าข้ CAN 0x100 และคุมคุ แขน/ปั๊มเอง

# 3.2 Flowchart

# 3.2.1 Flowchart การทำ งานโดยรวม

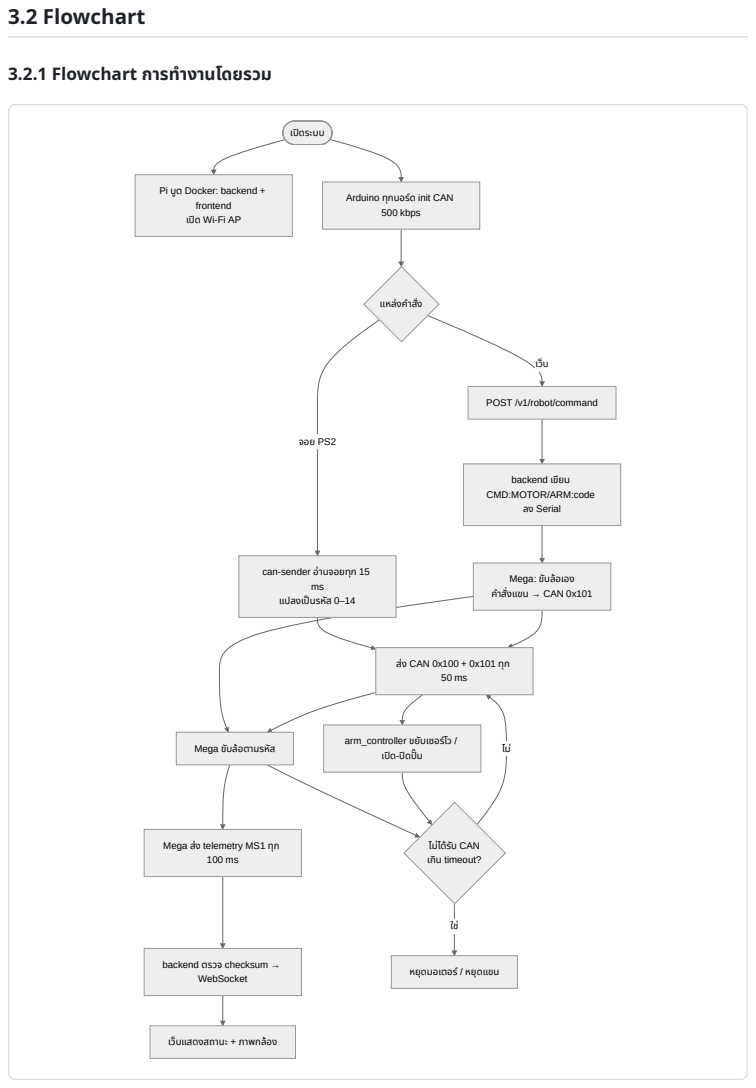
[picture p11: page 11]
จอย PS2; เปิดระบบ; Arduino ทุกทุ; บอร์ดร์; init CAN; 500 kbps; can-sender อ่านจอยทุกทุ; แปลงเป็นรหัสหั; CAN 0x100 + 0x101 ทุกทุ; backend เขียขี; ลง Serial; Mega: ขับขั; ล้อเอง; แขน → CAN 0x101; Mega ขับขั; ล้อตามรหัสหั; arm_controller ขยับยั; เซอร์โร์; Mega ส่งส่; telemetry MS1 ทุกทุ; WebSocket; แสดงสถานะ + ภาพกล้อง; CAN; เกิน timeout?

Pi บูต Docker: backend +

frontend

แหล่งคำ สั่งสั่

POST /v1/robot/command

CMD:MOTOR/ARM:code

backend ตรวจ checksum →

หยุดมอเตอร์ / หยุดแขน

# 3.2.2 Flowchart บอร์ดร์ arm_controller (Interrupt + Watchdog + Sleep + EEPROM)

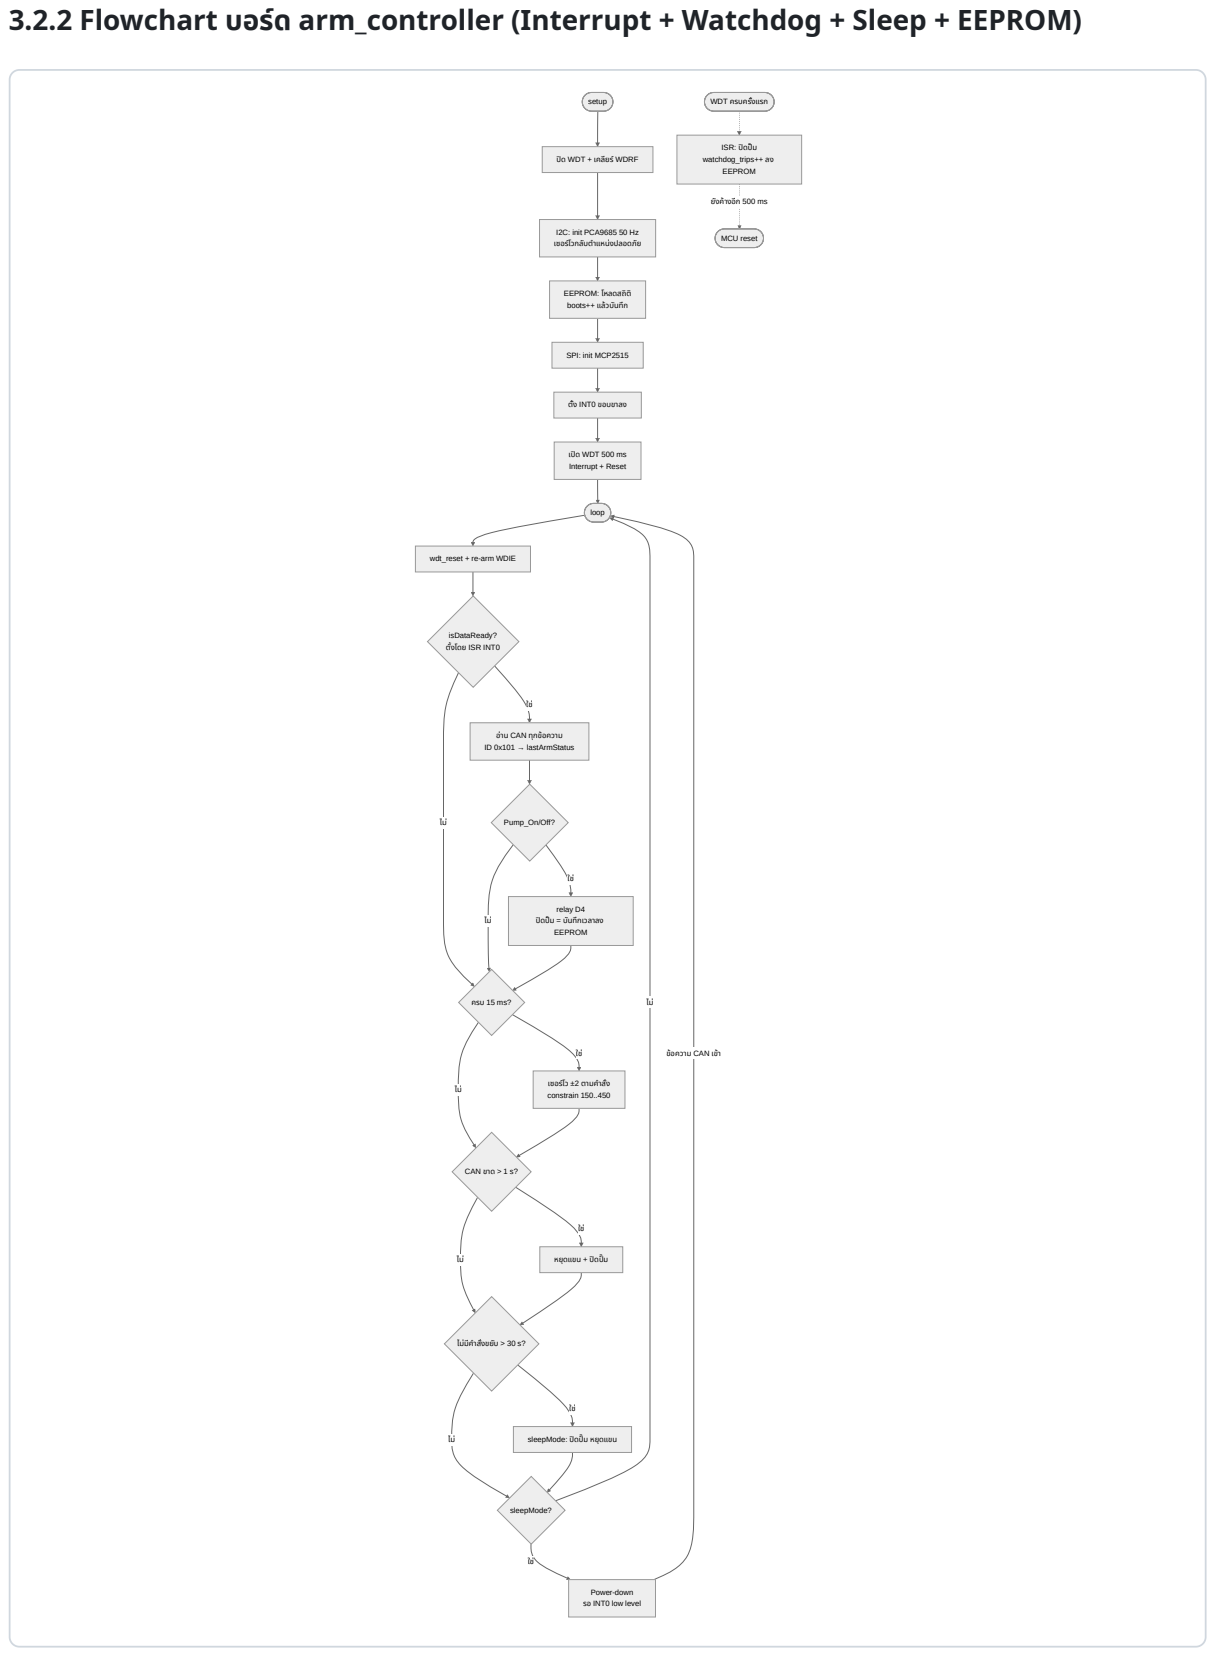
[picture p12: page 12]
ความ CAN เข้าข้; ค้างอีก 500 ms; setup; I2C: init PCA9685 50 Hz; เซอร์โร์; วกลับตำ แหน่งปลอดภัย; EEPROM: โหลดสถิติ; boots++ แล้วบันบั; SPI: init MCP2515; INT0 ขอบขาลง; loop; isDataReady? ตั้งตั้; โดย ISR INT0; อ่าน CAN ทุกทุ; ความ; ID 0x101 → lastArmStatus; Pump_On/Off?; relay D4 ปิดปั๊ม = บันบั; ทึกเวลาลง EEPROM; ครบ 15 ms?; ว ±2 ตามคำ สั่งสั่ constrain 150..450; CAN ขาด > 1 s?; คำมี; sleepMode?; WDT ครบครั้งรั้; แรก; MCU reset

ปิด WDT + เคลียร์ WDRF

ISR: ปิดปั๊ม watchdog_trips++ ลง EEPROM

เปิด WDT 500 ms
Interrupt + Reset

wdt_reset + re-arm WDIE

หยุดแขน + ปิดปั๊ม

sleepMode: ปิดปั๊ม หยุดแขน

Power-down
รอ INT0 low level

3.2.3 Flowchart บอร์ดร์ | can-sender และ motor_controller_simplify
3.3 การทำ งานในส่วส่ | นของ Hardware

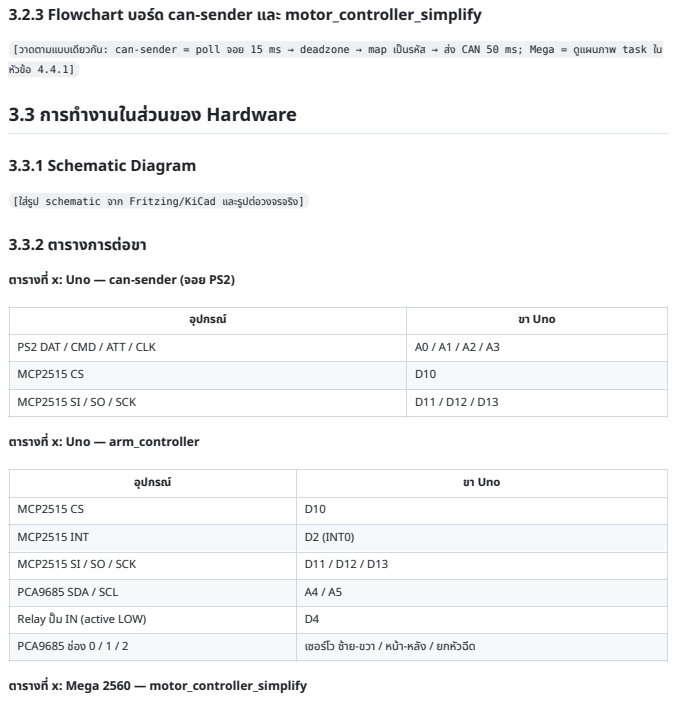
[picture p13: page 13]
[วาดตามแบบเดียดี; วกัน: can-sender = poll จอย 15 ms → deadzone → map เป็นป็; CAN 50 ms; Mega = ดูแดู; ผนภาพ task ใน; 3.3.1 Schematic Diagram; schematic จาก Fritzing/KiCad และรูปรู; ต่อวงจรจริงริ; 3.3.2 ตารางการต่อขา; ตารางที่ x: Uno — arm_controller; ตารางที่ x: Mega 2560 — motor_controller_simplify

ตารางที่ x: Uno — can-sender (จอย PS2)

อุปกรณ์ | ขา Uno

PS2 DAT / CMD / ATT / CLK | A0 / A1 / A2 / A3
MCP2515 CS | D10
MCP2515 SI / SO / SCK | D11 / D12 / D13

MCP2515 INT | D2 (INT0)
PCA9685 SDA / SCL | A4 / A5
Relay ปั๊ม IN (active LOW) | D4
PCA9685 ช่อช่ ง 0 / 1 / 2 | เซอร์โร์ ว ซ้าซ้ ย-ขวา / หน้าน้ -หลัง / ยกหัวหั ฉีด

อุปกรณ์ | ขา L298N | ขา Mega | หมายเหตุ
L298N #1 ช่อช่ ง A → M1 หน้าน้ ซ้าซ้ ย | ENA / IN1 / IN2 | D5 / D22 / D23 | ENA = PWM (Timer3)

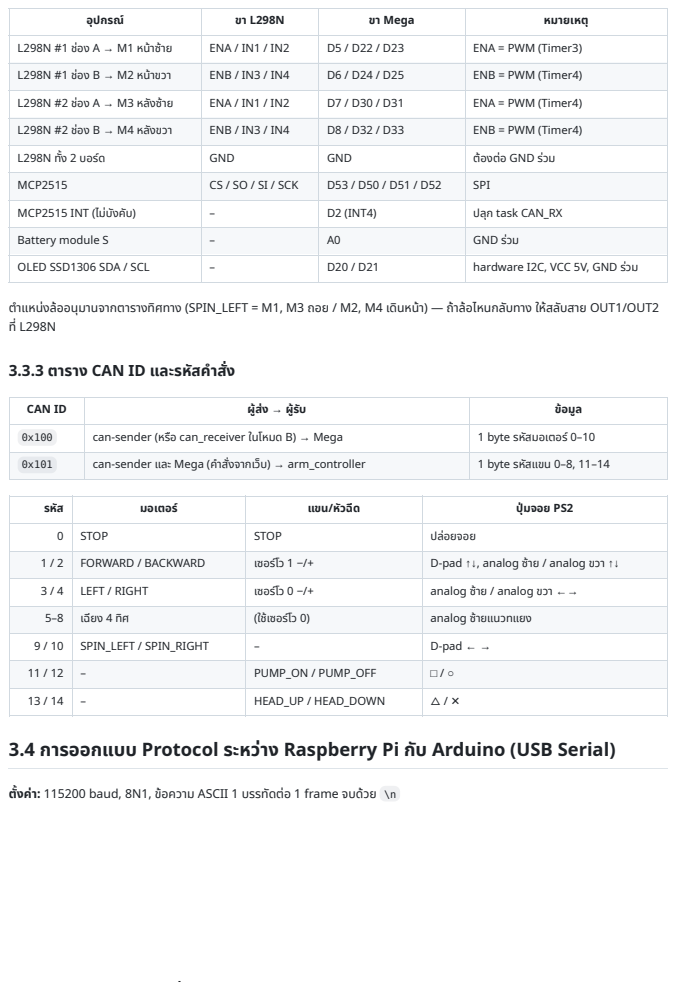
[picture p14: page 14]

L298N #1 ช่อช่ ง B → M2 หน้าน้ ขวา | ENB / IN3 / IN4 | D6 / D24 / D25 | ENB = PWM (Timer4)
L298N #2 ช่อช่ ง A → M3 หลังซ้าซ้ ย | ENA / IN1 / IN2 | D7 / D30 / D31 | ENA = PWM (Timer4)
L298N #2 ช่อช่ ง B → M4 หลังขวา | ENB / IN3 / IN4 | D8 / D32 / D33 | ENB = PWM (Timer4)
L298N ทั้งทั้ 2 บอร์ดร์ | GND | GND | ต้องต่อ GND ร่วร่ ม
MCP2515 | CS / SO / SI / SCK | D53 / D50 / D51 / D52 | SPI
MCP2515 INT (ไม่บัม่ งบั คับ) | – | D2 (INT4) | ปลุกลุ task CAN_RX
Battery module S | – | A0 | GND ร่วร่ ม
OLED SSD1306 SDA / SCL | – | D20 / D21 | hardware I2C, VCC 5V, GND ร่วร่ ม

3.3.3 ตาราง CAN ID และรหัสคำ สั่งสั่

CAN ID | ผู้ส่ผู้ งส่ → ผู้รัผู้ บรั | ข้อข้ มูล
0x100 | can-sender (หรือรื can_receiver ในโหมด B) → Mega | 1 byte รหัสหั มอเตอร์ 0–10
0x101 | can-sender และ Mega (คำ สั่งสั่ จากเว็บว็ ) → arm_controller | 1 byte รหัสหั แขน 0–8, 11–14

รหัส | มอเตอร์ | แขน/หัวฉีด | ปุ่มปุ่ จอย PS2
0 | STOP | STOP | ปล่อยจอย
1 / 2 | FORWARD / BACKWARD | เซอร์โร์ ว 1 −/+ | D-pad ↑↓, analog ซ้าซ้ ย / analog ขวา ↑↓
3 / 4 | LEFT / RIGHT | เซอร์โร์ ว 0 −/+ | analog ซ้าซ้ ย / analog ขวา ←→
5–8 | เฉียง 4 ทิศ | (ใช้เช้ ซอร์โร์ ว 0) | analog ซ้าซ้ ยแนวทแยง
9 / 10 | SPIN_LEFT / SPIN_RIGHT | – | D-pad ← →
11 / 12 | – | PUMP_ON / PUMP_OFF | □ / ○
13 / 14 | – | HEAD_UP / HEAD_DOWN | △ / ✕

# 3.4.1 Pi → Arduino (คำ สั่งสั่ )

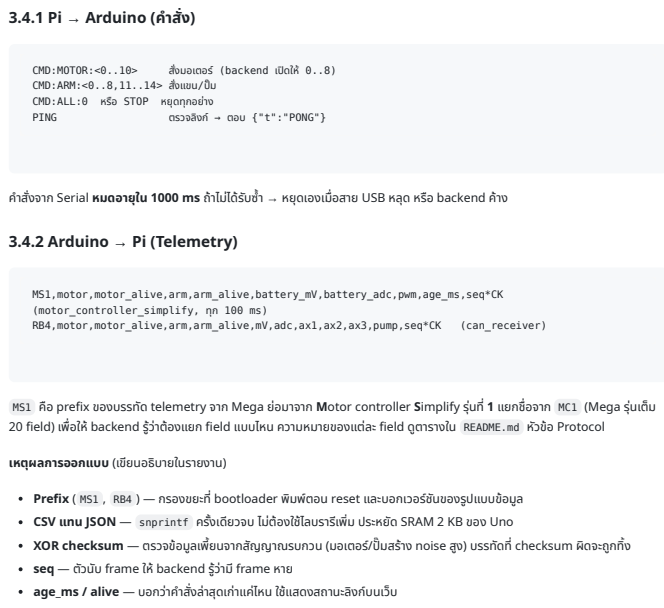
[picture p15: page 15]
CMD:MOTOR:<0..10>; มอเตอร์ (backend ร์; เปิดให้; CMD:ARM:<0..8,11..14> สั่งสั่; แขน/ปั๊ม; CMD:ALL:0 หรือรื; STOP หยุดทุกทุ; PING; ตรวจลิงก์; → ตอบ {"t":"PONG"}; จาก Serial หมดอายุใน 1000 ms ถ้าไม่ไม่; → หยุดเองเมื่อมื่; สาย USB หลุดลุ; backend ค้าง; (motor_controller_simplify, ทุกทุ; RB4,motor,motor_alive,arm,arm_alive,mV,adc,ax1,ax2,ax3,pump,seq*CK; (can_receiver); MS1 คือ prefix ของบรรทัด telemetry จาก Mega ย่อย่; มาจาก Motor controller Simplify รุ่นรุ่; ที่ 1 แยกชื่อชื่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

3.4.2 Arduino → Pi (Telemetry)

MS1,motor,motor_alive,arm,arm_alive,battery_mV,battery_adc,pwm,age_ms,seq*CK

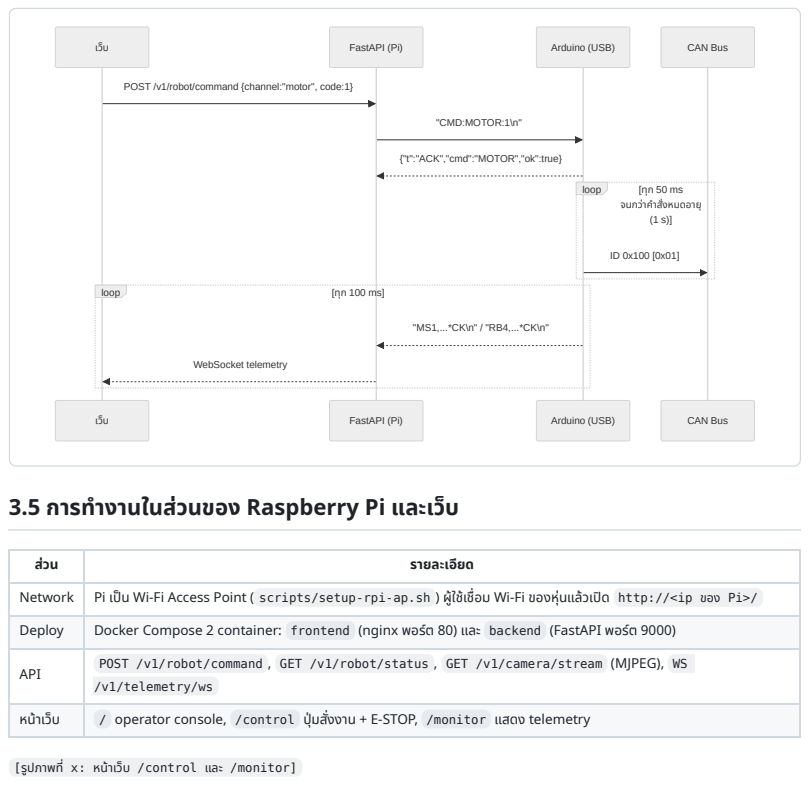
[picture p16: page 16]
FastAPI (Pi); Arduino (USB); CAN Bus; loop; จนกว่าว่; หมดอายุ; "CMD:MOTOR:1\n"; WebSocket telemetry; 3.5 การทำ งานในส่วส่; นของ Raspberry Pi และเว็บว็; ภาพที่; /control และ /monitor]

POST /v1/robot/command {channel:"motor", code:1}

{"t":"ACK","cmd":"MOTOR","ok":true}

ส่วส่ น | รายละเอียด

Network | Pi เป็นป็ Wi-Fi Access Point ( scripts/setup-rpi-ap.sh ) ผู้ใผู้ช้เช้ ชื่อชื่ ม Wi-Fi ของหุ่นหุ่ แล้วเปิดปิ http://<ip ของ Pi>/
Deploy | Docker Compose 2 container: frontend (nginx พอร์ตร์ 80) และ backend (FastAPI พอร์ตร์ 9000)
API | POST /v1/robot/command , GET /v1/robot/status , GET /v1/camera/stream (MJPEG), WS /v1/telemetry/ws

หน้าน้ เว็บว็ | / operator console, /control ปุ่มปุ่ สั่งสั่ งาน + E-STOP, /monitor แสดง telemetry

# บทที่ 4 Code และการทำ งาน

# 4.1 บอร์ดร์ can-sender (Uno + จอย PS2) — firmware/can-sender/

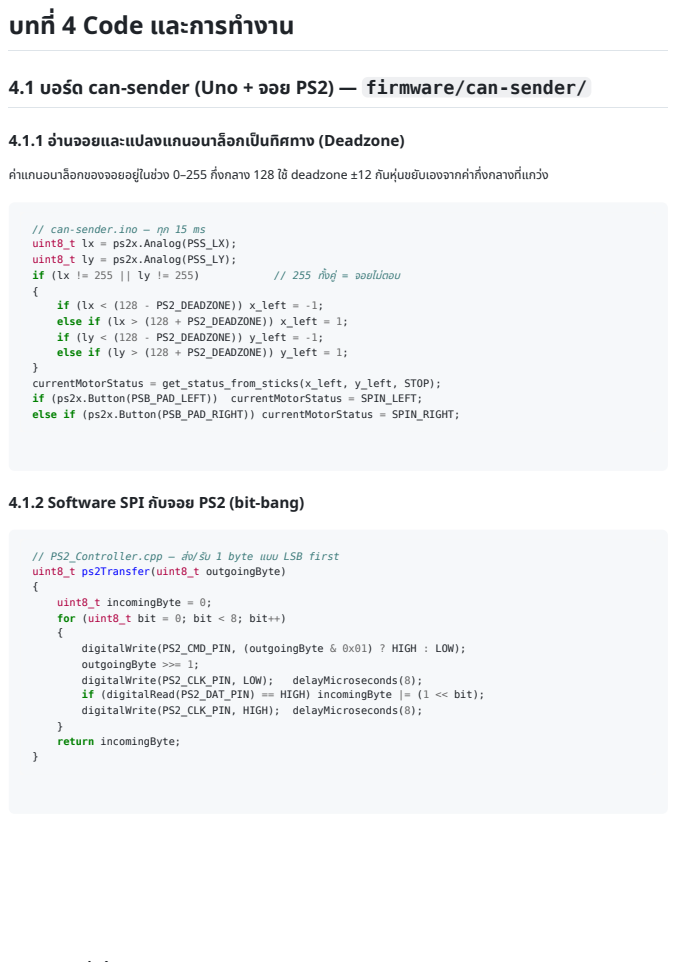
[picture p17: page 17]
4.1.1 อ่านจอยและแปลงแกนอนาล็อกเป็นป็; ทิศทาง (Deadzone); ค่าแกนอนาล็อกของจอยอยู่ใยู่; ง 0–255 กึ่งกลาง 128 ใช้ deadzone ±12 กันหุ่นหุ่; เองจากค่ากึ่งกลางที่แกว่งว่; // can-sender.ino — ทุกทุ; จอยไม่ตม่; // PS2_Controller.cpp — ส่งส่; 1 byte แบบ LSB first; digitalWrite(PS2_CLK_PIN, LOW);; delayMicroseconds(8);

uint8_t lx = ps2x.Analog(PSS_LX);
uint8_t ly = ps2x.Analog(PSS_LY);
if (lx < (128 - PS2_DEADZONE)) x_left = -1;
else if (lx > (128 + PS2_DEADZONE)) x_left = 1;
if (ly < (128 - PS2_DEADZONE)) y_left = -1;
else if (ly > (128 + PS2_DEADZONE)) y_left = 1;
currentMotorStatus = get_status_from_sticks(x_left, y_left, STOP);
if (ps2x.Button(PSB_PAD_LEFT)) currentMotorStatus = SPIN_LEFT;
else if (ps2x.Button(PSB_PAD_RIGHT)) currentMotorStatus = SPIN_RIGHT;

4.1.2 Software SPI กับจอย PS2 (bit-bang)

uint8_t ps2Transfer(uint8_t outgoingByte)
uint8_t incomingByte = 0;
for (uint8_t bit = 0; bit < 8; bit++)
digitalWrite(PS2_CMD_PIN, (outgoingByte & 0x01) ? HIGH : LOW);
outgoingByte >>= 1;
if (digitalRead(PS2_DAT_PIN) == HIGH) incomingByte |= (1 << bit);
digitalWrite(PS2_CLK_PIN, HIGH); delayMicroseconds(8);
return incomingByte;

4.1.3 ส่งส่ | คำ สั่งสั่ | ขึ้นขึ้ | CAN Bus (heartbeat 50 ms)

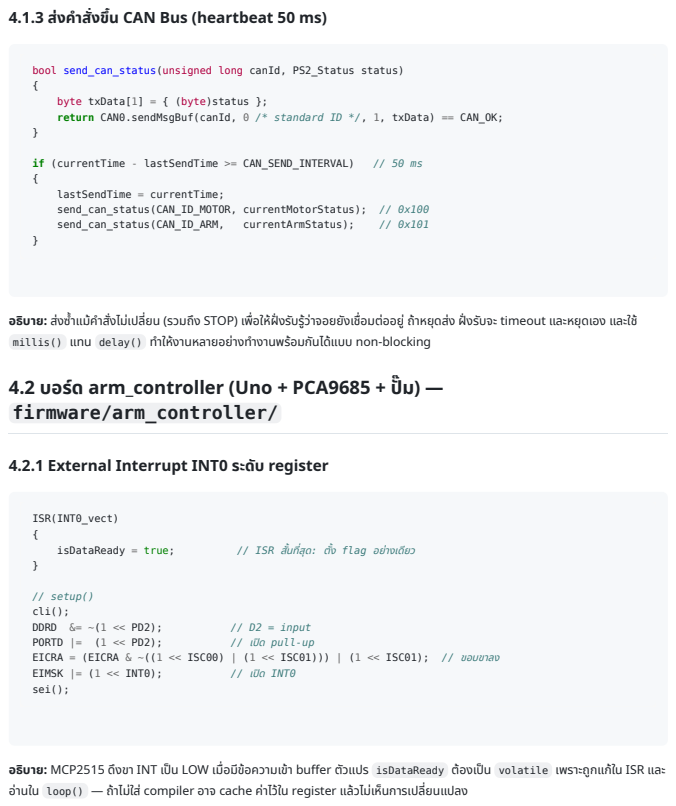
[picture p18: page 18]
if (currentTime - lastSendTime >= CAN_SEND_INTERVAL); lastSendTime = currentTime; send_can_status(CAN_ID_MOTOR, currentMotorStatus); // 0x100; send_can_status(CAN_ID_ARM,; currentArmStatus);; ซ้ำ แม้คำม้; ปลี่ยน (รวมถึง STOP) เพื่อพื่; จอยยังยั; มต่ออยู่ ถ้าหยุดส่งส่; จะ timeout และหยุดเอง และใช้; millis() แทน delay() ทำ ให้งห้; านหลายอย่าย่; งทำ งานพร้อร้; มกันได้แบบ non-blocking; 4.2 บอร์ดร์; arm_controller (Uno + PCA9685 + ปั๊ม) —; firmware/arm_controller/; ISR(INT0_vect) {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

bool send_can_status(unsigned long canId, PS2_Status status)
byte txData[1] = { (byte)status };
return CAN0.sendMsgBuf(canId, 0 /* standard ID */, 1, txData) == CAN_OK;

4.2.1 External Interrupt INT0 ระดับ register

// setup()
cli();
EICRA = (EICRA & ~((1 << ISC00) | (1 << ISC01))) | (1 << ISC01); // ขอบขาลง
sei();

# 4.2.2 Watchdog Timer ระดับ register (Interrupt + System Reset)

// 1) ตอนบูต: ปิด WDT ก่อน กันติด reset loop หลังโดน WDT reset
cli();
MCUSR &= ~(1 << WDRF);
WDTCSR |= (1 << WDCE) | (1 << WDE);
WDTCSR = 0x00;
sei();
// 2) หลัง init เสร็จร็ | : เปิดปิ | WDT แบบ Interrupt + System Reset, timeout 0.5 s
void watchdog_arm() {
cli();
wdt_reset();
WDTCSR |= (1 << WDCE) | (1 << WDE); | // timed sequence (ภายใน 4
clock)
WDTCSR = (1 << WDIE) | (1 << WDE) | (1 << WDP2) | (1 << WDP0); // WDP = 0101 → 0.5 s
sei();
}
// 3) ครบเวลาครั้งรั้แรก = loop ค้าง → ปิดปิ | ปั๊มทันที + บันบั | ทึกลง EEPROM (hardware ล้าง WDIE เอง)
ISR(WDT_vect) {
digitalWrite(RELAY_PUMP_PIN, RELAY_OFF_STATE);
stats.watchdogTrips++;
EEPROM.put(ARM_STATS_ADDRESS + offsetof(ArmStats, watchdogTrips), stats.watchdogTrips); }

// 4) ใน loop()
wdt_reset(); | // "feed the dog"
WDTCSR |= (1 << WDIE); | // เปิดปิ | WDIE กลับ (แก้บิตบิ | นี้อนี้ ย่าย่ งเดียวไม่ต้ม่ | ต้องใช้ timed sequence) ช้
อธิบธิ | าย: ถ้าโปรแกรมค้าง (เช่นช่ | I2C bus ค้าง) เกิน 500 ms ISR จะปิดปั๊มก่อนเลยและจดลง EEPROM ถ้ายังยั | ค้างต่ออีก 500 ms MCU จะ
reset แล้ว setup() สั่งสั่ | เซอร์โร์ | วกลับตำ แหน่งปลอดภัย — ปั๊มจึงจึ | ไม่ค้ม่ | ค้างเปิดพ่นพ่ | สาร และดูย้ดู | อย้ | นหลังได้ว่าว่ | บอร์ดร์ | เคยค้างกี่ครั้งรั้ | (พิมพิ | พ์ตพ์ | อนบูต)

ที่

# 4.2.3 I2C: Driver PCA9685 ที่เขียขี นเอง

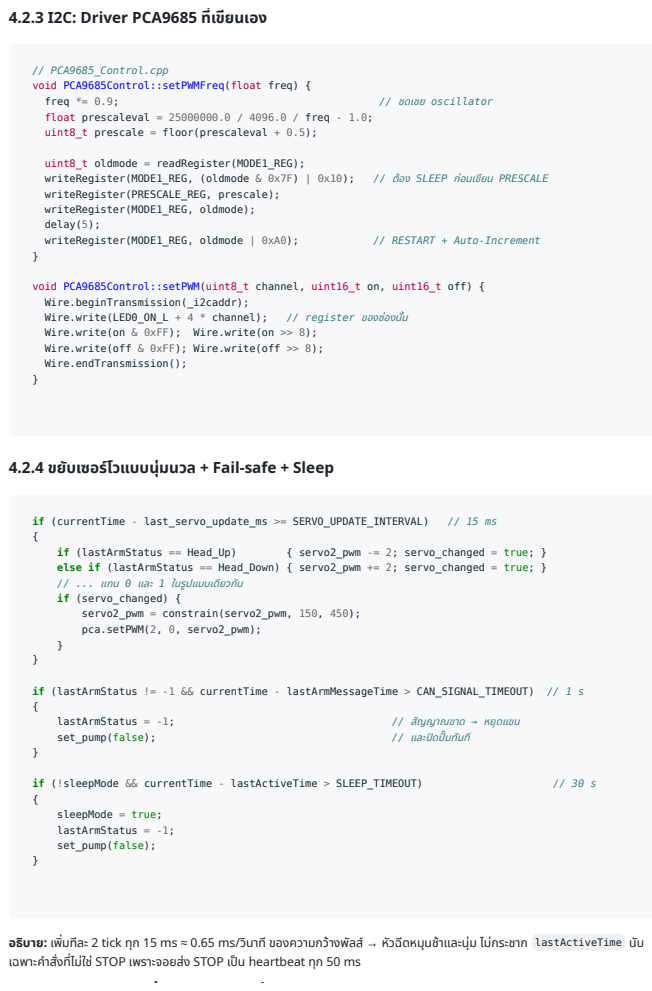
[picture p19: page 20]
freq *= 0.9;; // ชดเชย oscillator; uint8_t oldmode = readRegister(MODE1_REG);; writeRegister(MODE1_REG, (oldmode & 0x7F) | 0x10);; // ต้อง SLEEP ก่อนเขียขี; น PRESCALE; writeRegister(PRESCALE_REG, prescale); writeRegister(MODE1_REG, oldmode); delay(5);; writeRegister(MODE1_REG, oldmode | 0xA0);; // RESTART + Auto-Increment; Wire.write(LED0_ON_L + 4 * channel);; // register ของช่อช่; เซอร์โร์; วแบบนุ่มนุ่ นวล + Fail-safe + Sleep; if (currentTime - last_servo_update_ms >= SERVO_UPDATE_INTERVAL)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

// PCA9685_Control.cpp
void PCA9685Control::setPWMFreq(float freq) {
float prescaleval = 25000000.0 / 4096.0 / freq - 1.0;
uint8_t prescale = floor(prescaleval + 0.5);

void PCA9685Control::setPWM(uint8_t channel, uint16_t on, uint16_t off) {
Wire.beginTransmission(_i2caddr);
Wire.write(on & 0xFF); Wire.write(on >> 8);
Wire.write(off & 0xFF); Wire.write(off >> 8);
Wire.endTransmission();

4.2.5 EEPROM: สถิติที่จำ ข้าข้ | มการปิดปิ | เครื่อรื่ | ง

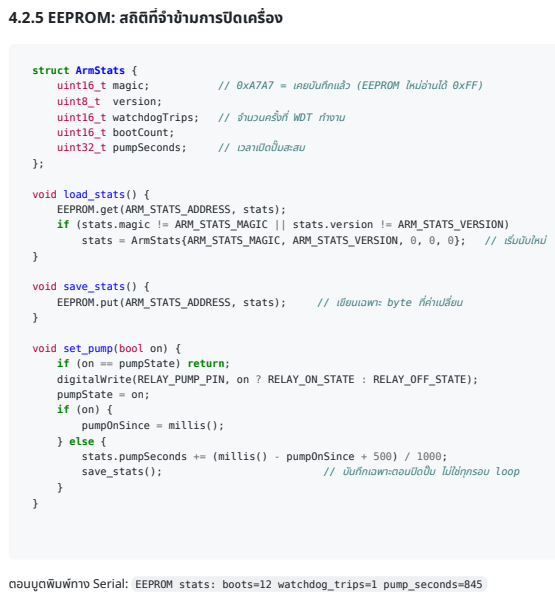
[picture p20: page 21]
struct ArmStats {; uint16_t magic;; // 0xA7A7 = เคยบันบั; ทึกแล้ว (EEPROM ใหม่อ่ม่; อ่านได้ 0xFF); uint8_t version;; uint16_t watchdogTrips;; // จำ นวนครั้งรั้; ที่ WDT ทำ งาน; uint16_t bootCount;; uint32_t pumpSeconds;; // เวลาเปิดปั๊มสะสม; stats = ArmStats{ARM_STATS_MAGIC, ARM_STATS_VERSION, 0, 0, 0};; นับใหม่; void save_stats() {; EEPROM.put(ARM_STATS_ADDRESS, stats);; นเฉพาะ byte ที่ค่าเปลี่ยน; save_stats();; ทึกเฉพาะตอนปิดปั๊ม ไม่ใม่ ช่ทุช่; รอบ loop; ตอนบูตพิมพิ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

void load_stats() {
EEPROM.get(ARM_STATS_ADDRESS, stats);
if (stats.magic != ARM_STATS_MAGIC || stats.version != ARM_STATS_VERSION)

void set_pump(bool on) {
if (on == pumpState) return;
digitalWrite(RELAY_PUMP_PIN, on ? RELAY_ON_STATE : RELAY_OFF_STATE);
pumpState = on;
pumpOnSince = millis();
} else {
stats.pumpSeconds += (millis() - pumpOnSince + 500) / 1000;
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
