SaktanuthPeak/durian-bot/(commit log)

2026-09-25 Add MS1 protocol, web hold-to-drive pad and canopy detection
    - Backend parses MS1 telemetry from the simplified Mega (with battery mV/ADC)
    and accepts motor spin codes 9/10.
    - /control gets drive, arm and pump buttons that repeat commands every 200 ms
    while held and send STOP on release; E-STOP is never disabled.
    - Fix the mecanum preview mapping spin to the old 11/12 codes.
    - OpenCV canopy detector (HSV mask, morphology, contours) annotates camera
    frames and reports canopy_ratio / canopy_detected on /v1/camera/status.
    - Example camera resolution raised to 640x480 for the Raspberry Pi 5.
    [camera_service.py, receiver_canbus.py, vision.py]
2026-09-25 Add Durian Bot README, report outline and Raspberry Pi 5 docs
    - Root README: hardware list, L298N wiring and cautions, Pi <-> Mega
    protocol with an MS1 field table, Pi 5 deployment and firmware upload.
    - docs/doc.md: report outline for the 240-319 mini project with course
    topics, flowcharts, code walkthroughs and a team-only gap appendix.
    - Update architecture/deployment docs and the deploy script from the
    Pi 3 (1 GB) to the Pi 5 (8 GB), which builds images natively.
2026-09-27 Refactor motor controller firmware: remove OLED display functionality
    - Deleted OLED display related files (oled_display.cpp and oled_display.h) as the display is no longer used in the project.
    - Updated README.md to reflect the removal of the OLED display and its associated library dependencies.
    - Modified motor_controller_simplify.ino to remove references to the OLED display and its task, streamlining the code and reducing memory usage.
    [motor_controller_simplify.ino]
2026-09-28 feat: remove ir sensor, update uis
